danielmaleh/nir-brain-stimulation/README.md

# Transcranial Photobiomodulation (tPBM) — NIR Brain Stimulation Device

An open, low-cost apparatus for delivering **pulsed 850 nm near-infrared light to the scalp** and recording its effect on cortical activity and motor performance. This repository contains everything needed to rebuild the device and run the protocol: Arduino firmware, a browser-based experiment application, an EEG marker bridge, and the calibration and bring-up procedures.

Built at EPFL for a within-subject study in healthy adults comparing **10 Hz NIR**, **40 Hz NIR**, and a **heating-only control**, with continuous EEG, wrist EMG, and an auditory reaction-time task.

---

## What the system is

Three components, each in its own directory, joined over USB serial and a localhost WebSocket:

```
   ┌──────────────────┐   Web Serial    ┌─────────────────┐   D9 ─► NIR LED strip (850 nm)
   │  Browser app     │◄───────────────►│  Arduino Uno    │   D10 ─► heater element
   │  APP/index.html  │   115200 bps    │  firmware/main  │   D2  ◄─ DS18B20 skin temp
   └────────┬─────────┘                 └─────────────────┘
            │ ws://127.0.0.1:3535
            ▼
   ┌──────────────────┐    LSL (~1 ms)   ┌─────────────────┐
   │  lsl_bridge.py   │─────────────────►│  NIC2 / Enobio  │──► EEG + EMG recording
   │ "tPBM-Markers"   │                  │                 │    with markers inside
   └──────────────────┘                  └─────────────────┘
```

- **`firmware/`** — generates the pulse train on a Timer1 compare interrupt (jitter-free 10.00 / 40.00 Hz), runs a feedforward + PI heater controller for the heating control, polls skin temperature every 200 ms, and latches a hard cut-off when the estimated skin-surface temperature reaches 37 °C (raw sensor ≥ 40 °C as backstop).
- **`APP/`** — runs the participant task in Chrome, drives the device over Web Serial, captures keypresses with `performance.now()`, and logs every trial to `localStorage` with CSV export.
- **`lsl_bridge/`** — translates browser events into numeric LSL markers so NIC2 writes them directly into the EEG file on a shared clock.

The device works standalone over USB; no laptop-side runtime is required beyond a browser.

---

## Study design

| | |
|---|---|
| **Participants** | 20 healthy adults, one session each |
| **Design** | Within-subject; the three conditions run in a per-participant randomised order |
| **Conditions** | `Heating Control` · `10 Hz NIR` · `40 Hz NIR` |
| **Per condition** | 13.5 min — a 5-min silent EMG-baseline phase, then a 5-min reaction-time phase, each split at its midpoint by a 1-min cooling break (stimulation off), then the stimulation-off gap (default 1.5 min) that ends every condition and separates it from the next. Stimulation is on for all 10 task minutes. (Changed 2026-10-20 from 10 + 7 min — see `docs/protocol_duration_change.md`.) |
| **Off gap after each block** | Stimulation off for a configurable gap (default 1.5 min, same as the pre gap) — this one window both ends the block and separates it from the next; the last block ends with it too |
| **Total in-protocol time** | ~44 min per participant at the defaults (2.2-min blocked-light calibration, 1.5-min pre gap, three 13.5-min conditions each ending in its 1.5-min off gap), plus EEG capping and setup |
| **Measures** | Continuous EEG (Enobio 32 via NIC2), wrist EMG on EXG channels, auditory reaction time, and a per-block sham-awareness answer (yes / no / don't know, asked by the experimenter when each block's stimulation ends) |
| **Blocked-light calibration** | Before the pre gap, with a card physically covering the light: 30 s each of 10 Hz, 40 Hz, heating and off, as a per-participant noise reference for the drive electronics; then a 10-s window to remove the card |

A **test session** (checkbox in the app's config panel) is identical in timing, structure and markers; it only stamps the CSV `TEST` so a dry run can never pass as participant data, and it is the only kind of session the app allows on a bench firmware build.

### Reaction-time task

A 600 Hz sine tone (10 ms attack, 150 ms decay, generated in the Web Audio API) is presented **5.0 s + a random [0, 2.0] s jitter** after the previous response. The participant presses the spacebar. Each tone opens a **2.0 s response window**; no press is logged as an `OMISSION` and the run continues. A press *before* the tone is a `FALSE_ALARM` and resets the timer. Reaction time is anchored to the *audible* tone onset, not the scheduling call.

---

## Light dose and safety

| Parameter | Value |
|---|---|
| Wavelength | 850 nm |
| Pulse frequencies | 10.00 Hz and 40.00 Hz (Timer1 CTC, prescaler 64) |
| Duty cycle | 50 % |
| Illumination area | ~4 cm² |
| Exposure per condition | 10 min (600 s) light-on, delivered as three blocks (2.5, 5 and 2.5 min) separated by two 1-min cooling breaks — the EMG→RT boundary has no break (pacing keeps skin temperature down) |
| Skin-contact temperature | Hard latching cut-off at an **estimated skin-surface temperature of 37.0 °C** (40 °C limit minus a 3 °C margin covering the estimate's worst-case error), with the raw sensor reading ≥ 40.0 °C as a backstop. The DS18B20 sits behind the contact surface and reads several degrees low and ~90 s late during a ramp, so the firmware estimates the surface from a per-temperature-range gap table plus the reading's slope — see `analysis/thermal/fit_surface_model.py`, which fits the table from a bench run with a reference probe at the contact point and must be re-run whenever the sensor, LED array or heater is remounted. |
| Heating-control set point | Replays, on the device sensor, the device-temperature trajectory recorded during the same session's NIR runs (mean of the preceding NIR runs at the same offset into the run, refreshed every 5 s); falls back to the calibrated profile (baseline + fixed rise) if Heating is the first condition. Tracked by a feedforward + PI controller (`HEATER_PID` telemetry carries the feedforward duty), heater duty capped at 20 % — at that cap the heater's plateau is ~+10 °C on the device sensor, so a residual shortfall against a faster NIR ramp is a power limit, not a control one |

> **Before running participants, measure the delivered irradiance at the scalp with a calibrated power meter** and compute the per-condition fluence as `irradiance × 600 s` (at the nominal ~21 mW/cm² — 84 mW over ~4 cm² — that is ~12.6 J/cm², above the window below, so the measured irradiance decides). Confirm the result against your ethics-approved dose and the published tPBM window (0.3–3 J/cm² useful range, ~5–100 mW/cm² irradiance — see References). Do not infer the dose from the drive current.

Non-negotiable safety properties, all enforced in firmware and verified by `firmware/safety_test/`:

- Skin temperature never exceeds 40 °C — the cut-off acts on the firmware's **estimated skin-surface temperature** (37 °C, i.e. 40 °C minus a 3 °C margin), **latches** and de-energises both channels; it only resets once the sensor reading is back below 40 °C. The raw reading ≥ 40 °C is a second, independent trip.
- A disconnected or faulty DS18B20 (reading −127 °C, or three consecutive 85 °C power-on values) latches a trip rather than failing open.
- The heater target is clamped to stay at least 1 °C below the cut-off, whatever value is commanded.
- Every pulse and temperature reading is timestamped and logged over USB serial.

**Blinding.** NIR at 850 nm is invisible, which is what makes the heating control meaningful. The mode-indicator LEDs are held **off** during active stimulation, and the participant-facing screen is deliberately plain. Do not add visible indicators that activate during a NIR condition.

---

## Repository layout

| Path | Contents |
|---|---|
| `firmware/main/` | Experiment controller — pulse generation, PID heating, safety latch, serial command interface |
| `firmware/io_test/` | Pin-by-pin wiring verification sketch |
| `firmware/safety_test/` | 40 °C cut-off proof — the go/no-go gate before any participant |
| `firmware/onewire_scan/` | DS18B20 bus scanner for diagnosing an undetected sensor |
| `firmware/*/pins.h` | Single source of truth for pin assignments |
| `APP/index.html`, `app.js` | Participant task + researcher dashboard |
| `APP/arduino.html`, `arduino.js` | Hardware dashboard — telemetry, manual control, safety state |
| `APP/io_test.html`, `wiring_check.html` | Bench diagnostics and the interactive wiring checklist |
| `APP/arduino_link.js`, `lsl_markers.js`, `serial_lock.js` | Web Serial link, marker client, cross-tab port arbitration |
| `lsl_bridge/` | WebSocket → LSL marker bridge and its self-test |
| `calibration/` | Thermal calibration script that matches the heating control to NIR warming |
| `hardware/` | Wiring documentation |
| `analysis/` | `trigger_codes.csv` codebook; `behavior/`, `eeg/`, `emg/` for analysis scripts |
| `docs/` | Marker integration guide, methods text, testing and validation procedures |

---

## Reproducing the setup

### 1. Build the hardware

You need an Arduino Uno, an 850 nm SMD2835 LED strip segment, a heater element, a DS18B20 with a 4.7 kΩ pull-up, logic-level MOSFET driver modules, and the supplies for each load.

Work through **`APP/wiring_check.html`** — open it in any browser (no device connection needed) and follow the interactive schematic. It groups the build into three passes: continuity, voltage, then functional. It reflects the current low-side MOSFET topology.

> `hardware/wiring_guide.md` documents an earlier TB6612FNG-based build of the same pin map. The Arduino pin assignments are identical either way; the driver hardware differs. Confirm which one you are building before wiring.

Two things that will bite you: **common ground is mandatory** (the supply negatives, driver grounds, and Arduino GND must all tie together, or the channels never switch), and the **4.7 kΩ pull-up on the 1-Wire data line** is not optional — without it the sensor reads −127 °C and the firmware trips at startup.

### 2. Flash and validate, in order

Install the `OneWire` and `DallasTemperature` libraries, then run the bring-up ladder. Do not skip ahead:

1. **`firmware/io_test/`** — open a serial monitor at 115200 baud (or `APP/io_test.html`). Send `A` and `B` to confirm the NIR and heater channels switch, `T` for a sane temperature, `C` to cycle all four indicator LEDs.
2. **`firmware/safety_test/`** — the safety gate. `H` / `L` toggle the loads, `S` simulates a 41.5 °C spike. **All outputs must cut off and stay off.** `R` must refuse to reset until the real temperature is under 40 °C.
3. **`firmware/main/`** — the full controller. Confirm a steady `PULSE,1` / `PULSE,0` cadence with no `PULSE_DROPPED` lines, and verify 10 Hz and 40 Hz on a scope or photodiode (±0.5 Hz tolerance).

`main` accepts single-letter commands over serial: `M` cycle mode, `G` start, `X` abort, `S` simulate over-temperature, `R` reset the safety latch, `H<temp>` set the heating target (e.g. `H38.25`).

### 3. Install the software

```bash
# LSL marker bridge (needs the native liblsl; bundled on most installs)
pip install -r lsl_bridge/requirements.txt

# Thermal calibration
pip install -r calibration/requirements.txt

# Serve the app — Web Serial requires a real origin, not file://
python -m http.server 8000     # then open http://localhost:8000/APP/
```

Chrome or Edge is required — the app depends on Web Serial and BroadcastChannel, which Firefox and Safari do not implement.

### 4. Calibrate the heating control

The heating control only works as a control if it warms the skin *the same amount* the NIR does. `calibration/calibrate_thermal.py` measures the plateau temperature reached under each condition and writes the matched set point to `thermal_profile.json`:

```bash
python calibration/calibrate_thermal.py --port /dev/cu.usbmodemXXXX
```

This is a **per-device** calibration, not a per-participant one — run it once for a given physical build, and again after any change to the LED segment, heater, or sensor placement. See `calibration/README.md`.

### 5. Run a session

Order matters. The marker outlet must exist before NIC2 starts looking for it:

1. Start the bridge: `python lsl_bridge/lsl_bridge.py` — wait for `LSL Markers outlet 'tPBM-Markers' is live`.
2. In NIC2, enable LSL and point the marker inlet at **`tPBM-Markers`** (case-sensitive, exact match).
3. Start the NIC2 recording.
4. Open `APP/index.html` in Chrome and click **Connect NIR Device** (the task page drives the device itself; do not connect the hardware dashboard during a session). Confirm the console shows `Firmware build: PROTOCOL` — a real session is refused on a BENCH build or without a connected device.
5. **Put the blocking card over the light**, enter the participant ID, and start. The first 2 min are the blocked-light calibration; remove the card when the screen says so (10-s window). The condition order is randomised automatically.
6. When each block's stimulation ends, the sidebar prompts you to ask *"Did you notice the stimulation?"* — click Yes / No / Don't know (the last block's prompt stays open after the session until answered).
7. Stop the NIC2 recording at the end. The app downloads the session CSV, the temperature CSV and a full JSON automatically (Chrome asks once to allow multiple downloads).

Full per-session detail, including Windows-specific pitfalls (COM-port exclusivity, Chrome's Memory Saver discarding the tab mid-session), is in **`SETUP.md`**. Run one full dry run before your first participant and confirm markers land in the recording at sensible times.

**If the device trips mid-session** (estimated skin surface ≥ 37 °C, or raw sensor ≥ 40 °C), the app pauses automatically, emits `SESSION_PAUSE` (code 40), waits until the estimated surface is ≤ 34 °C and the sensor ≤ 37.5 °C, then resumes the *same phase* and emits `SESSION_RESUME` (41). The session is not lost, but the pause is in the marker stream and should be accounted for in analysis.

---

## Data and analysis

Each session produces two aligned artefacts:

- **Behavioural CSV** exported from the app — per-trial reaction times, false alarms, omissions, contact temperature, and condition, all on a `performance.now()` timeline.
- **EEG/EMG recording** from NIC2 (`.easy` + `.info`, or `.edf`) with numeric markers written inline.

Markers are integers because NIC2 does not record string markers. The codebook is `analysis/trigger_codes.csv`, mirrored in `lsl_bridge.py` (`SIMPLE_CODES` / `COND_CODES`):

| Code | Event | Condition | Marker string | Source | Meaning |
|---|---|---|---|---|---|
| `255` | UNKNOWN | — | *(unrecognized)* | bridge | Marker string not in the codebook, or a `cond=` that could not be parsed. Reported on stderr. **Never 0** — the `.easy` trigger column is 0 whenever no marker is present, so a 0 code is indistinguishable from "nothing happened" and vanishes silently from the recording. |
| `1` | TONE | — | `TONE` | task page | Auditory stimulus onset. Reaction time is measured from here |
| `2` | RESPONSE | — | `RESPONSE;rt=312.4` | task page | Spacebar within the 2 s window (the RT value lives in the CSV, not the code) |
| `3` | FALSE_ALARM | — | `FALSE_ALARM` | task page | Spacebar *before* the tone (anticipation); resets the stimulus timer |
| `4` | OMISSION | — | `OMISSION` | task page | No press within the 2 s window (a miss) |
| `10` | SESSION_START | Heating Control | `SESSION_START;cond=Heating` | task page | Session begins, stimulation on |
| `11` | SESSION_START | 10 Hz NIR | `SESSION_START;cond=10Hz` | task page | Session begins |
| `12` | SESSION_START | 40 Hz NIR | `SESSION_START;cond=40Hz` | task page | Session begins |
| `15` | SESSION_END | Heating Control | `SESSION_END;cond=Heating` | task page | Session ends, stimulation off |
| `16` | SESSION_END | 10 Hz NIR | `SESSION_END;cond=10Hz` | task page | Session ends |
| `17` | SESSION_END | 40 Hz NIR | `SESSION_END;cond=40Hz` | task page | Session ends |
| `20` | EMG_START | — | `EMG_START` | task page | 5-min silent EMG-baseline phase begins (2.5 + 1 cool + 2.5; stimulation on, no tones) |
| `21` | EMG_END | — | `EMG_END` | task page | EMG phase ends |
| `22` | RT_START | — | `RT_START` | task page | 5-min reaction-time phase begins (2.5 + 1 cool + 2.5) |
| `23` | RT_END | — | `RT_END` | task page | Reaction-time phase ends |
| `29` | STIM_OFF | — | `STIM_OFF` | device | Stimulation block ended or aborted (NIR and heater off) |
| `31` | NIR_ON | 10 Hz NIR | `NIR_ON;cond=10Hz` | device | NIR light physically ON — 850 nm @ 10 Hz, 50 % duty |
| `32` | NIR_ON | 40 Hz NIR | `NIR_ON;cond=40Hz` | device | NIR light physically ON — 850 nm @ 40 Hz, 50 % duty |
| `34` | HEAT_ON | — | `HEAT_ON` | device | Heater element energised (heating-control condition, PID-regulated) |
| `35` | HEAT_OFF | — | `HEAT_OFF` | device | Heater element off |
| `40` | SESSION_PAUSE | — | `SESSION_PAUSE` | task page | Session frozen by a thermal shutdown (estimated skin surface ≥ 37 °C, or raw ≥ 40 °C); pairs with `99` |
| `41` | SESSION_RESUME | — | `SESSION_RESUME` | task page | Session resumed once the estimated surface was ≤ 34 °C and the sensor ≤ 37.5 °C |
| `42` | COOL_START | — | `COOL_START` | task page | Scheduled mid-phase cooling break begins (stimulation off). Planned pacing — not a safety event |
| `43` | COOL_END | — | `COOL_END` | task page | Scheduled cooling break over; stimulation back on, phase second half resumes |
| `44` | POST_START | — | `POST_START` | task page | Stimulation-off post gap begins — the last step of every condition (after `RT_END`, before `SESSION_END`) |
| `45` | POST_END | — | `POST_END` | task page | Post gap over; `SESSION_END` follows |
| `46` | PRE_START | — | `PRE_START` | task page | Stimulation-off pre gap begins — once, before the first condition's `SESSION_START` |
| `47` | PRE_END | — | `PRE_END` | task page | Pre gap over; the first `SESSION_START` follows |
| `48` | BLOCKED_START | — | `BLOCKED_START` | task page | Blocked-light calibration begins (card on the device) |
| `49` | BLOCKED_END | — | `BLOCKED_END` | task page | Blocked-light calibration over |
| `50` | BLOCKED_SEG | Heating Control | `BLOCKED_SEG;cond=Heating` | task page | 30-s blocked heating segment |
| `51` | BLOCKED_SEG | 10 Hz NIR | `BLOCKED_SEG;cond=10Hz` | task page | 30-s blocked 10 Hz segment (device `NIR_ON` 31 follows) |
| `52` | BLOCKED_SEG | 40 Hz NIR | `BLOCKED_SEG;cond=40Hz` | task page | 30-s blocked 40 Hz segment (device `NIR_ON` 32 follows) |
| `53` | BLOCKED_OFF | — | `BLOCKED_OFF` | task page | 30-s blocked stimulation-off segment |
| `54` | CARD_REMOVE | — | `CARD_REMOVE` | task page | 10-s window to remove the card; `PRE_START` follows |
| `99` | SAFETY_TRIP | — | `SAFETY_TRIP` | device | Thermal cut-off latched (estimated surface ≥ 37 °C, raw ≥ 40 °C, sensor fault, or 1-Wire timeout); all stimulation force-stopped |

Condition-bearing events are encoded as **base code + condition offset** (`Heating` = 0, `10Hz` = 1, `40Hz` = 2), which is why `30` is deliberately unused — the heating control emits `HEAT_ON` (34) instead of a `NIR_ON`. The arithmetic can still *produce* 30 (`NIR_ON` + Heating), which is a contradiction, so the bridge rejects it as invalid rather than writing it. A `cond=` that is missing or misspelt is likewise rejected, never defaulted to offset 0 — silently relabelling a 10 Hz run as the heating arm is unrecoverable after the fact. "Task page" codes originate in the browser app; "device" codes are derived from Arduino serial telemetry, so `11` (the task says stimulation started) and `31` (the device confirms the LED is pulsing) are independent confirmations.

**Keep these codes stable** — analysis scripts key off the exact integers. To epoch: group by the `SESSION_START` codes (10–12), split phases with `EMG_START` / `RT_START` (20 / 22), and confirm the light was physically on using `NIR_ON` (31 / 32) rather than assuming it from the condition label. Load NIC2 files with MNE, or XDF with pyxdf if you recorded via LabRecorder instead.

Expect ~1 ms of LSL synchronisation error plus ~1–3 ms of roughly constant localhost bridge latency — well within what an ERP or tPBM analysis needs. For sub-millisecond auditory ERP latencies you would need a hardware trigger.

---

## Documentation

| Document | Covers |
|---|---|
| [`SETUP.md`](SETUP.md) | Recording-computer install and the per-session startup sequence |
| [`docs/lsl_eeg_marker_integration.md`](docs/lsl_eeg_marker_integration.md) | Why the bridge exists, the full marker vocabulary, NIC2 configuration |
| [`docs/methods_software.md`](docs/methods_software.md) | Manuscript-level description of the control system |
| [`docs/testing_and_validation.md`](docs/testing_and_validation.md) | The bring-up ladder and what each sketch proves |
| [`hardware/wiring_guide.md`](hardware/wiring_guide.md) | Pinout table and per-component wiring |
| [`calibration/README.md`](calibration/README.md) | Thermal matching procedure |
| [`lsl_bridge/README.md`](lsl_bridge/README.md) | Bridge install, run, and self-test |

---

## References

- Vlahinić et al. (2020) — 850 nm, 10 Hz tPBM EEG study in healthy adults
- El Khoury et al. (2019) — 810 nm pulsed tPBM up to 100 mW/cm²
- Salehpour et al. (2018) — LED-based brain PBM review; 10–70 mW/cm² typical, 0.3–3 J/cm² useful fluence window
- [Lab Streaming Layer](https://labstreaminglayer.readthedocs.io/) · [Neuroelectrics LSL/TCP integration](https://www.neuroelectrics.com/lsl-tcp-integration)

---

## Contact

Daniel Elmaleh — EPFL — daniel.elmaleh@epfl.ch

Participant-facing documents and the study protocol are deliberately excluded from this repository.
