danielmaleh/nir-brain-stimulation/docs/lsl_eeg_marker_integration.md

# Tagging the EEG/EMG with Experiment Events — LSL, Enobio & NIC2

A plain-language guide to how we get our experiment's events (tones, key
presses, NIR stimulation on/off) written into the Enobio EEG/EMG recording as
time-stamped **markers**, so the brain/muscle data can be aligned to what
happened in the task.

---

## 1. Why we need this

The Enobio records a continuous stream of EEG (and EMG) samples. On its own,
that stream has no idea *when the participant heard a tone* or *when the 40 Hz
NIR light turned on*. To analyse the data we need to cut the continuous
recording into **epochs** around events — e.g. "the 1 second of EEG after each
tone", or "the EEG during 10 Hz vs 40 Hz stimulation". That requires the
recording to contain **markers**: little labelled flags placed at exact times.

The hard requirement is a **shared clock**: the marker's timestamp and the EEG
samples must be measured on the same timeline, or the epochs land in the wrong
place. Getting that shared clock is the whole job, and it is what Lab Streaming
Layer solves.

---

## 2. The systems and words

| Term | What it is |
|---|---|
| **Enobio (NE)** | The wireless EEG/EMG amplifier (the headset + electrodes). Also does EXG channels for wrist EMG. |
| **NIC2** | *Neuroelectrics Instrument Controller v2* — the PC software that talks to the Enobio, shows signal quality, and **saves the recording** (`.easy` / `.nedf` / `.edf`). |
| **LSL (Lab Streaming Layer)** | A small, free networking system for research. Each data source publishes a **stream**; LSL keeps all streams **synchronized to ~1 ms** on one clock. The standard glue for multimodal experiments. |
| **Outlet** | An LSL "sender". NIC2 publishes EEG as an outlet; our bridge publishes a *Markers* outlet. |
| **Inlet** | An LSL "receiver". NIC2 acts as an inlet for our markers; a recorder acts as an inlet for everything. |
| **Marker / trigger / annotation** | A short event label (a string like `TONE` or a code) placed at a precise time in the recording. Same idea, different names. |

### What NIC2 gives you over LSL
When LSL is enabled in NIC2, it exposes up to four outlets, named after a base
name you choose:

- `NAME-EEG` — the EEG samples
- `NAME-Accelerometer`
- `NAME-Quality` — per-channel signal quality
- `NAME-Markers` — markers

Crucially, **NIC2 can also *receive* markers** from another program (over LSL or
TCP) and **write them straight into the recording file**. That is the path we
use: our experiment produces markers, NIC2 files them next to the EEG. No
separate merge step needed.

---

## 3. Our architecture

Our experiment runs in a **web browser** (`APP/index.html` for the behavioural
task, `APP/arduino.html` for the hardware). Browsers **cannot speak LSL
directly** — LSL is a native (C/UDP) library, and browser JavaScript can't load
it or send the UDP/multicast traffic LSL uses.

So we insert a tiny **local bridge**: a small Python program (using the
`pylsl` library) that:

1. creates an LSL **Markers outlet** (e.g. named `tPBM-Markers`), and
2. listens on a **localhost WebSocket** for events from the browser, pushing
   each one to the outlet the instant it arrives.

```
  index.html   ─┐
                 ├─(localhost WebSocket, ws://127.0.0.1:PORT)─►  Python bridge
  arduino.html ─┘                                                (pylsl outlet
                                                                   "tPBM-Markers")
                                                                        │
                                                                   LSL network
                                                                    (~1 ms sync)
                                                                        │
                                                        NIC2  ──►  writes markers INTO
                                                                   the EEG/EMG recording
```

- The **behavioural app** sends: run/condition start & end, tone onset, key
  press (with reaction time), premature press, and no-response omissions.
- The **hardware dashboard** sends: NIR stimulation start/stop (10 Hz / 40 Hz),
  heating on/off, and safety trips — these mark *when the light was actually on*,
  which for a tPBM study is the most important thing to align the EEG to.

> **Alternative:** instead of NIC2 receiving the markers, you can run the free
> **LabRecorder** tool, which records *every* LSL stream (NIC2's EEG **and** our
> markers) together into one **XDF** file. Both approaches give time-aligned
> data; NIC2-direct keeps everything in NIC2's native file, LabRecorder gives a
> single portable XDF. We default to **NIC2-direct** for simplicity.

---

## 4. The marker vocabulary and numeric codes

> **Important — NIC2 only records NUMERIC markers.** Its docs say plainly *"Do
> not send marker names as objects like 'hand'."* So the browser sends readable
> strings, and **`lsl_bridge.py` translates each into an integer code** before
> pushing to the `tPBM-Markers` LSL outlet (an `int32` Markers stream). NIC2
> stores the integer; you map it back to the event during analysis using the
> table below. (If your NIC2 is configured for "numeric-string" markers rather
> than int32, set `MARKER_FORMAT = "string"` at the top of `lsl_bridge.py`.)

The condition suffix (`Heating`/`10Hz`/`40Hz`) is folded into the code as
an offset, so each condition gets its own number:

Each **session** is one condition, 10 min of task = a 5-min EMG phase then a 5-min
reaction-time phase; each phase is split at its midpoint by a 1-min stimulation-off cooling break, and a 1.5-min stimulation-off post gap ends the condition.

| Marker string (browser → bridge) | Code (bridge → NIC2) | When it fires | Source |
|---|---|---|---|
| `TONE` | `1` | auditory stimulus onset (reaction-time phase) | task page |
| `RESPONSE;rt=312.4` | `2` | space pressed in the window (RT in ms; kept in the CSV, not the code) | task page |
| `FALSE_ALARM` | `3` | space pressed before the tone (anticipation) | task page |
| `OMISSION` | `4` | no press within the 2 s window | task page |
| `SESSION_START;cond=…` | `10`/`11`/`12` | session begins, stimulation on (Heating/10Hz/40Hz) | task page |
| `SESSION_END;cond=…` | `15`/`16`/`17` | session ends, stimulation off (Heating/10Hz/40Hz) | task page |
| `EMG_START` / `EMG_END` | `20` / `21` | 5-min EMG baseline phase start/end (split by a 1-min cooling break) | task page |
| `RT_START` / `RT_END` | `22` / `23` | 5-min reaction-time phase start/end (split by a 1-min cooling break) | task page |
| `SESSION_PAUSE` / `SESSION_RESUME` | `40` / `41` | session frozen by a thermal shutdown (estimated skin surface ≥37 °C, raw ≥40 °C backstop) / resumed once the estimate ≤34 °C and sensor ≤37.5 °C | task page |
| `COOL_START` / `COOL_END` | `42` / `43` | scheduled mid-phase cooling break: stimulation off at each phase midpoint for 1 min / back on for the second half (planned pacing, not a safety event) | task page |
| `POST_START` / `POST_END` | `44` / `45` | stimulation-off post gap ending every condition: 1.5 min after `RT_END`, before `SESSION_END` | task page |
| `PRE_START` / `PRE_END` | `46` / `47` | stimulation-off pre gap, once per participant: 1.5 min before the first `SESSION_START` | task page |
| `BLOCKED_START` / `BLOCKED_END` | `48` / `49` | blocked-light calibration (card covering the light), once per participant, before the pre gap | task page |
| `BLOCKED_SEG;cond=…` / `BLOCKED_OFF` | `50`/`51`/`52` / `53` | its 30-s segments: Heating / 10 Hz / 40 Hz, then off | task page |
| `CARD_REMOVE` | `54` | 10-s window to remove the card | task page |
| `NIR_ON;cond=…` | `31`/`32` | NIR light physically ON (10Hz/40Hz) | device telemetry |
| `STIM_OFF` | `29` | device stimulation block ends/aborts | device telemetry |
| `HEAT_ON` / `HEAT_OFF` | `34` / `35` | heater element switches (heating condition) | device telemetry |
| `SAFETY_TRIP` | `99` | thermal cutoff latched (estimated surface ≥37 °C, raw ≥40 °C, sensor fault) | device telemetry |
| *(anything unrecognized, or a `cond=` that cannot be parsed)* | `255` | written into the recording so the problem is visible; never 0 (0 = no marker in the `.easy` file) | bridge |

The codebook lives in `lsl_bridge.py` (`SIMPLE_CODES` / `COND_CODES`). Keep the
codes **stable** — your analysis scripts key off these exact integers. The
bridge prints the whole codebook at startup and logs each `event -> code` as it
fires, so you can watch the mapping live.

---

## 5. Setup checklist (once per session)

1. **Install the bridge dependencies** (one time): `pip install pylsl websockets`.
   `pylsl` needs the native `liblsl` library present (bundled on most installs;
   otherwise install `liblsl`).
2. **Start the bridge** program *before* NIC2's recording. It prints something
   like `LSL Markers outlet 'tPBM-Markers' is live`.
3. **Configure NIC2**: enable LSL, and in NIC2's marker/LSL settings point it at
   the outlet name **`tPBM-Markers`**.
   - ⚠️ The name is **case-sensitive** and must match *exactly*.
   - ⚠️ The marker outlet **must already exist** (bridge running) *before* you
     start the NIC2 protocol/recording, or NIC2 won't find it.
4. **Start the NIC2 recording.**
5. **Open the experiment** in Chrome; it connects to the bridge automatically.
   Run the session as normal.
6. **Stop the NIC2 recording** at the end. The markers are now inside the file.

**Sanity check before real participants:** run one short test session and
confirm the markers appear in the NIC2 recording at sensible times (e.g. a `TONE` roughly every ~5–7 s during the RT phase, each followed by a `RESPONSE` or `OMISSION`).

---

## 6. Timing accuracy — what to expect

- LSL synchronizes streams to about **1 ms**, which is well within what an ERP
  or tPBM analysis needs.
- Our localhost bridge adds a small, roughly constant **~1–3 ms** delay between
  the browser event and the LSL push. That is fine for this study.
- The behavioural app already captures the *true* event time with
  `performance.now()` (microsecond resolution) and anchors the tone marker to
  the **audible onset** (including audio output latency). If you ever need
  sub-millisecond precision (e.g. exact auditory ERP latencies), the bridge can
  forward that original timestamp so LSL stamps the marker at the true event
  time rather than at receipt — or you move to a **hardware trigger**, which is
  the gold standard but needs extra electronics.

---

## 7. Analysis (later)

- **NIC2 native file** (`.easy` + `.info`, or `.edf`): markers appear as an
  events column / annotations. In Python, load with **MNE** and read the events
  into annotations; epoch around each marker string.
- **XDF file** (if you used LabRecorder): load with **pyxdf**, then hand the EEG
  stream + marker stream to MNE. The two share LSL timestamps, so alignment is
  automatic.
- Group epochs by condition using the `SESSION_START` codes (10/11/12), split the
  EMG vs reaction-time phases with `EMG_START`/`RT_START` (20/22), and confirm the
  light was physically on with the `NIR_ON` codes (31/32) — to compare 10 Hz vs
  40 Hz vs heating.

---

## 8. References

- Neuroelectrics — [LSL & TCP Integration](https://www.neuroelectrics.com/lsl-tcp-integration)
- Neuroelectrics Support — [Set Up LSL](https://supportne.freshdesk.com/support/solutions/articles/35000292694-set-up-lsl)
- Neuroelectrics Wiki — [Interacting with NIC](https://ne-wiki.netlify.app/index.php/interacting_with_nic)
- Lab Streaming Layer — [official docs & LabRecorder](https://labstreaminglayer.readthedocs.io/)
- `pylsl` (Python bindings) — [pypi.org/project/pylsl](https://pypi.org/project/pylsl/)

---

*Implementation: `lsl_bridge/lsl_bridge.py` (bridge), `APP/lsl_markers.js`
(browser client), `analysis/trigger_codes.csv` (codebook).*
