danielmaleh/nir-brain-stimulation/docs/figures/session_timeline.png

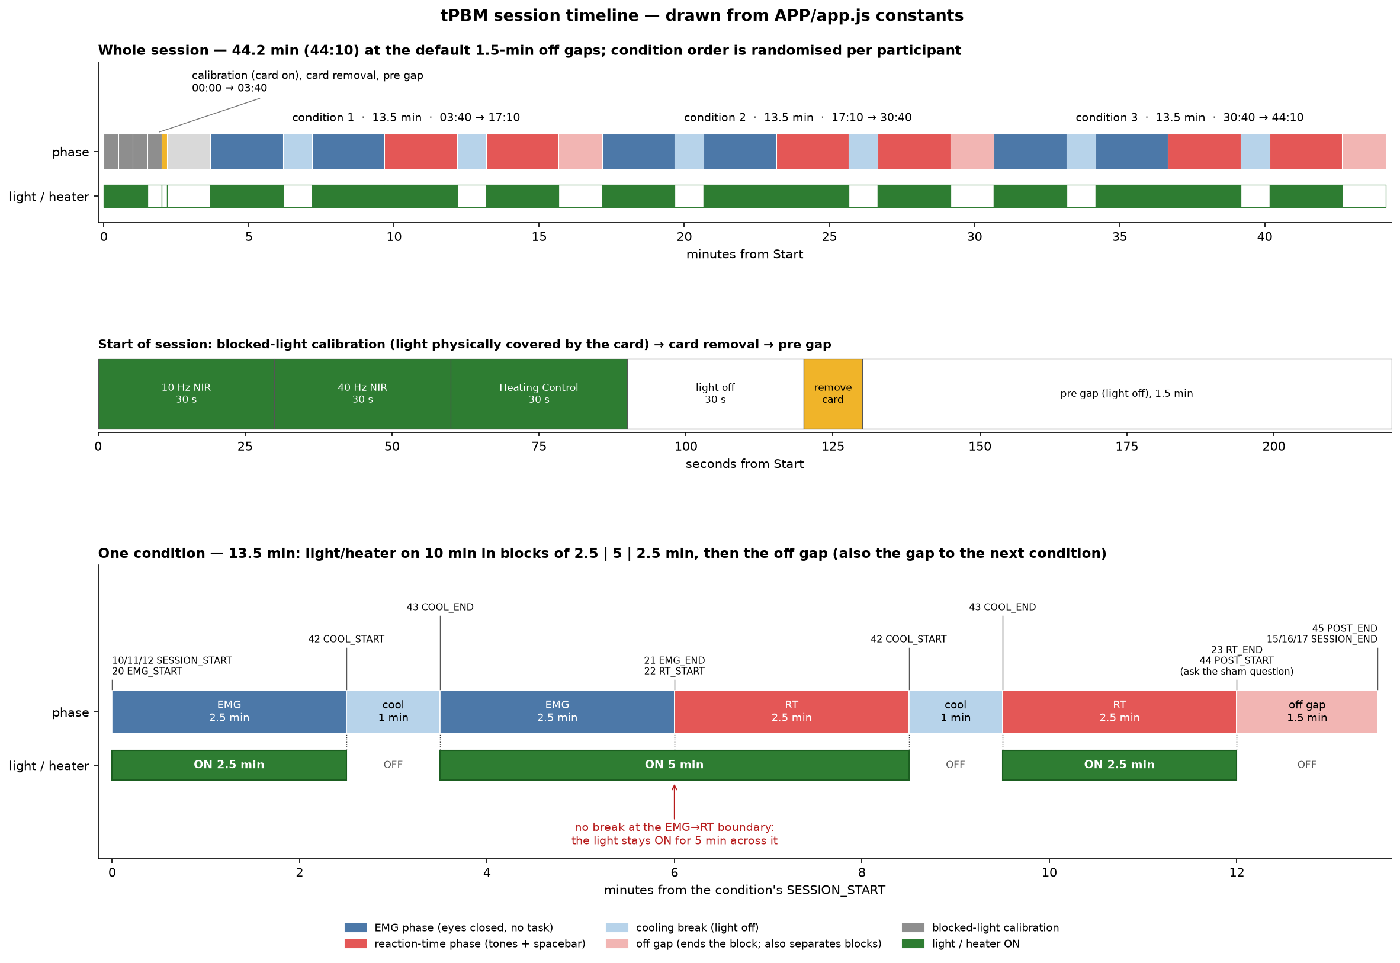
docs/figures/session_timeline.png
