danielmaleh/nir-brain-stimulation/analysis/trigger_codes.csv

code | event | condition | source | description
255 | UNKNOWN |  | bridge | Unrecognized marker string, or a cond= that could not be parsed (see the bridge stderr; add it to the codebook in lsl_bridge.py). Never 0: the .easy trigger column is 0 when no marker is present, so a 0 code would be indistinguishable from 'nothing happened'.
1 | TONE |  | task | Auditory stimulus onset during the reaction-time phase. Reaction time is measured from here.
2 | RESPONSE |  | task | Spacebar pressed within the 2 s response window. The RT in ms is in the behavioural CSV, not the code.
3 | FALSE_ALARM |  | task | Spacebar pressed before the tone (anticipation). Resets the stimulus timer.
4 | OMISSION |  | task | No press within the 2 s response window (a miss).
10 | SESSION_START | Heating Control | task | Session begins (stimulation starts) — heating control condition.
11 | SESSION_START | 10 Hz NIR | task | Session begins — 850 nm NIR pulsed at 10 Hz.
12 | SESSION_START | 40 Hz NIR | task | Session begins — 850 nm NIR pulsed at 40 Hz.
15 | SESSION_END | Heating Control | task | Session ends (stimulation stops) — heating control condition.
16 | SESSION_END | 10 Hz NIR | task | Session ends — 10 Hz NIR.
17 | SESSION_END | 40 Hz NIR | task | Session ends — 40 Hz NIR.
20 | EMG_START |  | task | 5-min silent EMG-baseline phase begins (2.5 min + 1-min cooling break + 2.5 min; no tones/clicks; stimulation is on outside the break).
21 | EMG_END |  | task | EMG phase ends.
22 | RT_START |  | task | 5-min reaction-time phase begins (2.5 min + 1-min cooling break + 2.5 min; tones + responses).
23 | RT_END |  | task | Reaction-time phase ends.
40 | SESSION_PAUSE |  | task | Session frozen by a thermal shutdown (skin temp exceeded 40 C); paired with SAFETY_TRIP.
41 | SESSION_RESUME |  | task | Session resumed after the temperature recovered to <=37.5 C (stimulation restarted).
42 | COOL_START |  | task | Scheduled mid-phase cooling break begins (stimulation off). Planned pacing, NOT a safety event — each phase is split at its midpoint by a 1-min break.
43 | COOL_END |  | task | Scheduled cooling break over; stimulation back on and the phase second half resumes.
44 | POST_START |  | task | Stimulation-off post gap begins — the last step of every condition (RT_END precedes it, SESSION_END follows). 1.5 min.
45 | POST_END |  | task | Post gap over; SESSION_END follows.
46 | PRE_START |  | task | Stimulation-off pre gap begins — once per participant, before the first condition's SESSION_START. 1.5 min.
47 | PRE_END |  | task | Pre gap over; the first SESSION_START follows.
48 | BLOCKED_START |  | task | Blocked-light calibration begins — card physically covering the light; per-participant noise reference of the drive electronics.
49 | BLOCKED_END |  | task | Blocked-light calibration over.
50 | BLOCKED_SEG | Heating Control | task | Blocked-light calibration: 30-s heating segment (card on).
51 | BLOCKED_SEG | 10 Hz NIR | task | Blocked-light calibration: 30-s 10 Hz NIR segment (card on; device NIR_ON 31 follows).
52 | BLOCKED_SEG | 40 Hz NIR | task | Blocked-light calibration: 30-s 40 Hz NIR segment (card on; device NIR_ON 32 follows).
53 | BLOCKED_OFF |  | task | Blocked-light calibration: 30-s stimulation-off segment.
54 | CARD_REMOVE |  | task | 10-s window to remove the blocking card; PRE_START follows.
29 | STIM_OFF |  | hardware | Device stimulation block ended or aborted (NIR/heater off).
31 | NIR_ON | 10 Hz NIR | hardware | NIR light physically ON — 850 nm pulsed at 10 Hz, 50% duty.
32 | NIR_ON | 40 Hz NIR | hardware | NIR light physically ON — 850 nm pulsed at 40 Hz, 50% duty.
34 | HEAT_ON |  | hardware | Heater element energised (heating-control condition; PID-regulated).
35 | HEAT_OFF |  | hardware | Heater element off.
99 | SAFETY_TRIP |  | hardware | 40 C skin-temperature safety cutoff latched — all stimulation force-stopped.
