danielmaleh/nir-brain-stimulation/(commit log)

2026-06-23 Initial project scaffold for NIR tPBM brain stimulation study
    Sets up folder structure, CLAUDE.md with full project context (device specs,
    safety requirements, light dose parameters, software architecture), and
    copies study documents into docs/. Arduino firmware and Python analysis
    code to be built incrementally.
2026-07-02 Add design spec for interactive wiring verification schematic
2026-07-02 Fix pins.h include so sketches actually compile in Arduino builds
    Arduino copies the sketch to a temp build folder, so the relative
    include ../main/pins.h could never resolve. Symlink pins.h into each
    sketch folder instead, keeping firmware/main/pins.h the single source
    of truth.
    [io_test.ino, main.ino, pins.h, safety_test.ino]
2026-07-02 Add interactive wiring verification schematic (APP/wiring_check.html)
    Clickable SVG schematic of every connection (Arduino, TB6612, DS18B20,
    NIR strip, heater, PSU, indicator LEDs) with per-wire test instructions
    in bring-up order and confirmation state persisted in localStorage.
2026-07-02 Clarify STBY on io_test page: tied to 5V by default, driver always enabled
    When the firmware reports TB6612_STBY,NA the indicator now shows
    enabled and the Y toggle disables itself instead of implying the
    driver must be switched on manually.
2026-07-03 Auto-reconnect dashboards after tab discard/reload
    Chrome Memory Saver discards inactive tabs; the reloaded page lost its
    Web Serial connection. On load, reuse the already-granted port
    (preferring USB vendor 0x2341 = Arduino) and reconnect without a picker.
2026-07-03 Draw TB6612FNG as the real breakout module in the wiring schematic
    Red PCB with the actual pad layout (pins 1-8: VM VCC GND A01 A02 B01
    B02 GND; pins 16-9: PWMA AIN2 AIN1 STBY BIN1 BIN2 PWMB GND), pin
    numbers as printed on the board, and the page re-routed to match:
    loads and 12V on the output side, Arduino facing the control side.
2026-07-10 Rework wiring schematic for MOSFET + 24V topology
    The LED strip is a 24V part (6 LEDs per resistor group), which the
    TB6612 cannot drive (VM max ~15V). Redraw the schematic as two
    logic-level N-channel MOSFET low-side switches: load+ to supply+,
    load- to MOSFET drain, source to a common ground bus, Arduino D9/D10
    to the gates. NIR on 24V; heater on its own rail pending a rated-
    voltage check. Firmware/pin map unchanged (still PWM-gates D9/D10).
    Checklist rewritten to 26 items in bring-up order; net IDs re-verified
    against the SVG.
2026-07-10 Reaction-time task: don't stall on a missed keypress
    Previously the next tone was only scheduled from handleKeyPress, so if
    the participant never pressed space the run went silent until it timed
    out. Add a 2s response window after each tone: no press logs a
    NO_RESPONSE omission, increments missedCount, and schedules the next
    stimulus so the run continues. A press within the window cancels the
    pending miss. Misses are persisted per-run and shown in the summary.
    Verified end-to-end over CDP: tone -> NO_RESPONSE -> next tone (run
    continues), and a press within the window logs a response with no
    spurious miss.
2026-07-13 Add LSL marker bridge and wire experiment events to it
    New lsl_bridge/ (Python): publishes an LSL 'tPBM-Markers' outlet and
    relays browser events to it over a localhost WebSocket, so NIC2 (or
    LabRecorder) time-stamps them into the Enobio EEG/EMG recording.
    APP/lsl_markers.js: best-effort browser sender (auto-reconnect, drops
    rather than buffers when offline so timing stays correct).
    Wired markers:
    - app.js: RUN_START;cond, STIM (at audible onset), RESPONSE;rt,
    PREMATURE, NO_RESPONSE, RUN_END;cond
    - arduino.js: STIM_ON;cond, STIM_OFF, HEATER_ON/OFF, SAFETY_TRIP
    - index.html/arduino.html include lsl_markers.js
    Verified end-to-end: bridge self-test (WS->LSL PASS); driving index.html
    headle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
2026-07-14 Fix hardware dashboard showing UNKNOWN state/mode at idle
    Two display bugs made the dashboard look dead even though the board
    responds: (1) main never announces IDLE at boot, so state stayed
    UNKNOWN — on connect the Uno resets into IDLE+Heating, so show that
    immediately; (2) TEMP_LOG carries condition -1 while idle, which the
    mode display wrote every second, clobbering the selected mode back to
    UNKNOWN even after Cycle Mode — only update the mode display during
    stimulation (condIdx >= 0).
2026-07-15 Fix hardware-dashboard safety bugs, add live condition switch and cross-tab serial lock
    Firmware (firmware/main/main.ino):
    - Reject the DS18B20 +85 C power-on artifact (gate reads on isConversionComplete,
    SENSOR_SUSPECT after repeats) so it no longer falsely trips the 40 C cutoff
    - Emit explicit PULSE,0/HEATER,0 on abort/trip; keep polling temp during a trip;
    emit STATE_CHANGE on reset so the dashboard clears
    - Allow live condition switching (M) during stimulation via COND_SWITCH
    Dashboard (APP/): handle COND_SWITCH + SENSOR_SUSPECT, auto-scaling temp
    sparkline, clear stale actuator/safety UI. New serial_lock.js coordinates the
    hardware and I/O-diagnostics tabs so they stop stealing the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
    [main.ino]
2026-07-16 Bridge: translate string markers to integer codes for NIC2
    NIC2 only records numeric markers, so string markers (STIM_ON;cond=40Hz)
    were silently dropped and never reached the EDF. The bridge now maps each
    event to a stable integer code via a documented codebook and pushes an int32
    Markers stream (MARKER_FORMAT switch for numeric-string NIC2 setups).
2026-07-16 Task page drives Arduino NIR stimulation per run
    The experiment task page (index.html) now owns the serial port and drives the
    Arduino: at each run it selects the matching condition and starts stimulation,
    stopping it at run end/abort so the NIR follows the task's 40s/20s clock (not
    the firmware's 60s timer). Wrist EMG keeps the board OFF. New arduino_link.js
    reuses serial_lock.js (dashboard yields the port) and re-emits the hardware LSL
    markers (STIM_ON/OFF, HEATER, SAFETY_TRIP) since the dashboard is disconnected
    during a session. Uses the existing firmware command set (no reflash).
2026-07-17 Add trigger-code lookup table for analysis
    analysis/trigger_codes.csv maps every integer marker code NIC2 records back to
    its event, condition, source, and meaning. Verified against lsl_bridge.py so the
    table and the bridge codebook cannot drift.
    [trigger_codes.csv]
2026-07-18 Add NIR-matched heating-control thermal calibration
    Heating control now reproduces the temperature the NIR stimulation reaches,
    matching the warmth confound instead of a fixed 37.5 C set point.
    - firmware: mutable heater set point + 'H<temp>' serial command (clamped below
    the 40 C cutoff) so the host can set the matched target at run time.
    - calibration/calibrate_thermal.py: runs 10/40 Hz for the run duration, records
    DS18B20 temperature, computes the plateau, and stores thermal_profile.json
    (canonical in calibration/, browser copy in APP/). Persistent, calibrate once.
    - APP/arduino_link.js: loads the profile and sends the matched target before the
    heating-control run; falls back to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
    [calibrate_thermal.py, main.ino]
2026-07-20 Add PID closed-loop control for the heating condition
    Replaces the on-off hysteresis thermostat with a PID controller that holds the
    (NIR-matched) heating-control target tightly. Output is applied as a
    time-proportioned slow-PWM duty over a 1 s window, so it needs no PWM pin and
    cannot collide with the Timer1 NIR pulse generator (which never runs in the
    heating condition). Recomputed at 5 Hz; integral anti-windup and an EMA-smoothed
    derivative (Kd defaults to 0 given the 10-bit sensor). Streams HEATER_PID
    diagnostics (duty/temp/target) at 1 Hz for tuning. Gains are starting values and
    must be tuned on hardware; the 40 C latching cutoff still overrides everything.
    HEATER_USE_PID=0 reverts to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
    [main.ino]
2026-07-22 Heater safety: 50% duty cap + rate-of-rise trip
    After a 24V heater thermal-runaway (ran to 100 C; the firmware 40 C cutoff could
    not stop it because the MOSFET stayed conducting), add two software mitigations:
    HEATER_MAX_DUTY caps heater power at 50%, and a rate-of-rise cutoff trips if temp
    climbs >5 C/s (catches a runaway ~1 s sooner). Neither protects against a shorted
    MOSFET -- an independent in-line thermal fuse is still required. Compile-only;
    not yet hardware-tested.
    [main.ino]
2026-07-23 Delta-based heating match + cleaner thermal calibration
    Match the NIR's temperature RISE, not an absolute temperature: bench ambient
    (~room temp) is far below skin (~32-34C), so an absolute target is meaningless.
    - calibrate_thermal.py: store heating_rise_c (plateau minus baseline, averaged
    over 10/40Hz); cool_until_stable() waits for thermal equilibrium between
    conditions (robust vs chasing a fixed ambient). Schema bumped to v2.
    - arduino_link.js: track live TEMP_LOG; at a heating run read the baseline skin
    temp and target baseline + rise via H<setpoint>. Falls back to firmware default.
    - firmware: HEATER_MAX_DUTY 0.20 (the NIR job is a gentle ~0.75C rise; 20% is
    ample, higher woul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
    [calibrate_thermal.py, main.ino]
2026-07-27 Lower heater target floor to 20C; add 1-Wire scanner sketch
    - firmware: HEATER_TARGET_MIN 25->20 C so delta-matched targets (baseline + ~0.74C
    rise) aren't clamped on a cool bench / cool room. The 39C ceiling (safety clamp)
    is unchanged.
    - firmware/onewire_scan: throwaway DS18B20 bus diagnostic (presence pulse + ROM
    enumeration) that pinpointed the loose sensor wire; kept as a reusable tool.
    [main.ino, onewire_scan.ino]
2026-07-27 Robust experiment-page serial connection + temp monitor + stop-reason
    Fixes the experiment page (index.html) dropping offline right after connecting
    and never driving the device (worked on the dashboard, not the real page):
    - arduino_link.js: no double-open (connect() no-ops if already connected;
    openPort closes stale handles); removed the cross-tab takeover RACE (connect
    opens directly; a busy port gives a clear "disconnect the dashboard" message);
    the experiment page now HOLDS the port firmly and never yields; detects
    unexpected drops (readLoop exit) and reports OFFLINE with a reason; watchdog
    distinguishes CONNECTED-but-silent from RECEIVING.
    - Live contact-temperature monitor o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
2026-07-28 17-min EMG+RT sessions, stim throughout, redesigned NIC2 markers, temp in CSV
    Session restructure (app.js/index.html): 3 conditions (Heating/10Hz/40Hz), Wrist
    EMG dropped as a condition. Each session is 17 min = 10-min silent EMG-baseline
    phase (no tones/clicks) + 7-min reaction-time phase; NIR/heating runs the whole
    time. Two-phase run lifecycle, M:SS phase countdowns, participant rest screen
    during EMG.
    Firmware: STIMULATION_DURATION_MS raised 60s -> 18 min safety ceiling (the host
    ends runs; this only fires if the host never does) — fixes the pilot LED dropout.
    Markers redesigned for meaning: SESSION_START/END, EMG_START/END, RT_START/END,
    TONE, RESPONSE, FALSE_ALARM, OMISSION, NIR_ON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
    [trigger_codes.csv]
2026-07-28 Thermal shutdown -> auto-pause, wait for cool-down, resume same phase
    If a safety cutoff (>40 C) fires mid-session, the experiment now freezes instead
    of running on with no stimulation:
    - Pause: stop the phase countdown + tones, remember the phase and time left, show
    a "Paused - cooling down" screen, and mark SESSION_PAUSE (SAFETY_TRIP already
    sent by the device layer). Keypresses/tones are suppressed while paused.
    - Resume: watch the temperature; once it recovers to <=37.5 C, clear the device
    trip ('R'), restart the condition's stimulation, show a "Good temperature -
    resuming" message, mark SESSION_RESUME, and continue the SAME phase with the
    exact time that was left.
    arduino_lin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
    [trigger_codes.csv]
2026-08-06 Clear stale Timer1 OCF1A flag before arming the NIR pulse ISR
    Every NIR run began with a degenerate PULSE,1/PULSE,0 pair ~12 us apart
    at STIM_START, before the real train. It was a real (optically
    negligible) 12 us LED assertion, not a logging artifact.
    The Arduino core's init() leaves Timer1 free-running with OCR1A = 0, so
    TCNT1 hits the compare value constantly and OCF1A stays latched in TIFR1
    with nothing to clear it. startNirPulse() enabled OCIE1A with that flag
    pending, so the ISR fired on the very next instruction and toggled the
    just-raised NIR pin back LOW.
    Clear OCF1A (write-1-to-clear) before enabling the interrupt. This makes
    arming idempotent regardless of prior Timer1 state, a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
2026-08-06 Retune heater PID from measured step response; fix anti-windup clamp
    The heating control has to reproduce the NIR's calibrated +0.74 C rise
    (calibration/thermal_profile.json), but a bench step test overshot a
    2.5 C set point by 2.75 C -- roughly 4x the entire effect it exists to
    imitate.
    Characterised the thermal process from that step response (22.0 -> 24.0 C
    at 20% duty): initial rise 0.0403 C/s, Newton cooling gives tau ~= 253 s,
    process gain K ~= 51 C per unit duty, sensor/transport lag theta ~= 40 s.
    Holding +0.74 C needs only ~1.45% duty, but Kp = 0.60 commanded a capped
    20% on that error -- ~14x the steady-state requirement -- so the output
    stayed saturated straight through the set p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
    [main.ino]
2026-08-06 Report Web Serial failures the operator can act on
    The dashboard reported every connection failure as the same generic
    "Connection failed: <message>", and Chrome's own text is actively
    misleading: requestPort() says "No port selected by the user" both when
    the chooser was dismissed AND when no chooser was ever presented. The
    second case happens in embedded browser panes that do not implement the
    Web Serial picker, and it reads as though the operator cancelled.
    That cost real bench time today -- repeated failed connects while lsof
    showed nothing holding the port, because the picker was never rendered.
    describeSerialError() now distinguishes the cases, telling the two
    NotFoundError variants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
2026-08-06 Add project README with the LSL/EEG marker codebook
    Documents the system end to end: what the three components are and how
    they connect, the study design, the light dose and safety properties,
    the repository layout, and the reproduction path from wiring through the
    firmware bring-up ladder to running a session.
    Includes the full trigger codebook -- code, event, condition, marker
    string, source and meaning for all 24 markers -- mirroring
    analysis/trigger_codes.csv and the SIMPLE_CODES / COND_CODES tables in
    lsl_bridge.py. Also documents the base-code-plus-condition-offset scheme
    (Heating 0, 10Hz 1, 40Hz 2) and why code 30 is deliberately unused: the
    heating control emits HEAT_ON (34) rather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
2026-08-06 Make unencodable markers loud instead of silently wrong
    Three ways a marker could be lost or mislabelled in the recording, all
    silent, all only discoverable after a participant had been run.
    UNKNOWN_CODE 0 -> 255. The trigger column of a Neuroelectrics .easy file
    is 0 whenever no marker is present, so encoding an unrecognised marker
    as 0 made it indistinguishable from "nothing happened" -- it vanished.
    255 is outside the codebook and shows up in any downstream check.
    Alias HEATER_ON/HEATER_OFF -> HEAT_ON/HEAT_OFF. The dashboard emits the
    first spelling, the codebook defines the second, so heater events were
    encoded as unknown -- which, with the old UNKNOWN_CODE of 0, meant they
    disappeared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
    [trigger_codes.csv]
2026-08-06 Announce the active thermal cutoff on every boot
    The board carries no record of which firmware it holds. After a bench
    session that raised MAX_SAFE_TEMP, the only trace was a comment in a
    branch you might not be on -- so a serial log gave no way to tell
    afterwards whether a run had thermal protection.
    setup() now prints a machine-greppable BUILD line every boot:
    BUILD,PROTOCOL,cutoff=40.0
    BUILD,BENCH,cutoff=150.0
    and, when the cutoff differs from the protocol's 40 C, a loud human
    banner as well -- including a specific warning when the cutoff is above
    the DS18B20's 125 C range, where the check is unreachable rather than
    merely higher.
    Derived from MAX_SAFE_TEMP by comparing it against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
2026-08-28 Add a test-session toggle: 5-min conditions + firmware build gate
    A "Test session" checkbox in the config panel runs a shortened bench
    dry-run: 2.5 min EMG + 2.5 min RT per condition instead of 10 + 7.
    Markers, randomisation, rest pauses and stimulation control are
    unchanged -- only the two phase durations switch -- and the run is
    stamped TEST in the session log, the calibration card, and a loud
    banner line in the exported CSV, so a dry-run can never pass as
    participant data. The toggle locks while a session is active and
    unlocks on reset.
    The toggle deliberately does NOT touch the thermal cutoff. MAX_SAFE_TEMP
    is compiled into the firmware; no page control can change it, and wiring
    the saf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
2026-09-14 Split each real-session phase with a 1.5-min mid-phase cooling break
    Bench measurements (2026-08) showed the rig climbing ~1.5-2.5 C/min at
    protocol duty with no plateau, so an unbroken 10-min EMG or 7-min RT
    phase walks the skin temperature into the 40 C cutoff mid-session. Real
    sessions now split each phase at its midpoint and switch stimulation
    OFF for a fixed 1.5-min cool-down, then resume the second half:
    EMG 5:00 | cool 1:30 | EMG 5:00 | RT 3:30 | cool 1:30 | RT 3:30
    Per-condition time goes 17 -> 20 min (~57 -> ~66 min in-protocol); the
    delivered light energy is unchanged - the same 17 minutes of on-time,
    paced. Test sessions still run their phases unbroken.
    The breaks are marked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
    [trigger_codes.csv]
2026-09-17 Keep task events out of cooling breaks; one tone chain after the break
    A spacebar press during an RT cooling break fell through handleKeyPress
    (runPhase stays 'RT' during the break), logged FALSE_ALARM and started a
    self-sustaining TONE/OMISSION loop with stimulation OFF, because none of
    the task paths checked inCoolingBreak. resumeRtSecondHalf then scheduled
    a fresh chain without clearing the old timers, so two tone chains raced
    through the second half (extra tones; RTs could be measured against the
    wrong tone). Analysis treats COOL_START..COOL_END (42/43) as task-free,
    stimulation-off windows, so this inflated false-alarm and omission counts
    and could corrupt second-half RTs.
    Reproduced o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
2026-09-17 Draw false alarms on the chart again; fix stale comments and timer reset
    - plotDataPoints still filtered for PREMATURE_PRESS, the event name
    before c4b5c0e, so false alarms were never drawn. They are logged as
    FALSE_ALARM and now appear again as the small baseline dots on the
    live chart, redrawn on the next valid response as before.
    - resetControlInterface set the time-left readout to '40.0s', left over
    from the old 40-second runs; it now shows '--:--', the page's initial
    value.
    - Comments said a miss is logged as NO_RESPONSE; the event and marker
    are OMISSION (code 4).
    - The scheduleNextStimulus doc said [0, 1s] jitter; JITTER_MAX_MS is 2 s.
    Verified on the real page: a false a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
2026-09-22 Add thermistor-vs-device temperature alignment tool
    Joins an external thermistor log with the app's temperature CSV on shared
    wall-clock time, interpolates the thermistor at each device reading, and
    emits aligned/per-phase CSVs plus an HTML plot. This is the tool behind
    the 2026-09-11 bench finding that the device DS18B20 under-reads by up
    to ~9.5 C and lags ~57 s during ramps — the numbers driving the sensor
    placement/cutoff review before participants.
2026-09-23 Trip the safety cutoff on an estimated skin-surface temperature
    The DS18B20 sits behind the contact surface. Against a reference probe
    at the skin-contact point it read several degrees LOW and ~90-100 s LATE
    during a warming ramp: on 2026-09-11 the surface reached 42.5 C while
    the device read 34.0 and the 40 C cutoff never fired. The final device
    carries no surface probe, so the firmware now estimates the surface
    from the device reading alone and trips on the estimate.
    Model (fitted, not hand-tuned):
    surface = device + gap[device] + rate * (device - device_40s_ago) / 40
    gap[] is a per-temperature-range table (nodes every 2 C, linear between)
    and `rate` carries the lag. A table WITHOUT t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
2026-09-23 Heating replays the session's NIR device-temperature trajectory; add post gap
    HEATING CONTROL. The control condition must reproduce, on the device
    sensor, what that sensor recorded during the same participant's NIR
    runs -- not a fixed rise calibrated on another day with another build
    (the July +0.74 C target was being hit exactly while the LEDs now warm
    the bench surface by +13-15 C). At heating-run start the page builds
    the device-temperature trajectory of every NIR run already completed
    in this session from the temperature log, and every 5 s sends the mean
    of those runs at the same offset into the run as an H command. The
    provider is armed before runCondition() so its initial H already
    car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
    [trigger_codes.csv]
2026-10-04 Add a stimulation-off pre gap before the first condition
    Conditions 2 and 3 are preceded by an off period (the previous
    condition's post gap plus the rest), and every condition ends with the
    post gap, but the first condition started stimulating the moment the
    session began. A 1.5-min stimulation-off pre gap now runs once, before
    the first SESSION_START, so every condition has an off window on both
    sides. It applies to test sessions too.
    Marked PRE_START/PRE_END (46/47), added to the bridge, the trigger
    codebook, README and the marker guide. No run is open yet during the
    gap, so it is recorded in the session data (preGapMs), the temperature
    log (phase PRE) and the marker stream rather than i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
    [trigger_codes.csv]
2026-10-07 Give test sessions the same cooling-break structure as real ones
    Test sessions already had the pre gap and the post gap, but ran their
    5-min phases unbroken. They now split each phase at the midpoint with a
    1-min stimulation-off cooling break (TEST_COOLING_BREAK_MS; real
    sessions keep 1.5 min), so a dry run exercises exactly the structure,
    timers and markers a participant session does:
    PRE_START/END, SESSION_START, EMG_START, COOL_START/END, EMG_END,
    RT_START, COOL_START/END, RT_END, POST_START/END, SESSION_END
    phaseSplit() is now true for both kinds; coolingBreakMs() picks the
    duration. The config-panel description and the calibration card show
    the test-session shape. CSV stays stampe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
2026-10-07 Add static figure renderer for aligned thermistor/device tables
    Produces the PNG/PDF/SVG version of an align_thermistor.py table for
    slides and papers (the HTML it writes is for on-screen reading). This
    is the script behind the 2026-09-17 device-vs-probe figure that drove
    the surface-estimate cutoff.
2026-10-20 Promote the 5+5-min timing to the protocol; blocked-light calibration; sham question; auto-export; heater trajectory tracking
    PROTOCOL TIMING. The former test-session timing is now the protocol:
    EMG 2.5 | cool 1 | EMG 2.5 | RT 2.5 | cool 1 | RT 2.5 | post gap 1.5
    = 13.5 min per condition, 600 s light-on (was 10 + 7 min, 1020 s, with
    1.5-min breaks). Test sessions keep identical timing and differ only in
    the TEST stamp and bench-build gating. README, CLAUDE.md, the marker
    guide, the bridge comments and trigger_codes.csv are updated, and
    docs/protocol_duration_change.md tabulates original / interim / current
    timing, whole-session time (57 -> 72 -> ~50 min), fluence formulas and
    nominal numbers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
2026-10-26 Readiness audit fixes: real-session gate, block-3 sham answer, abort races, firmware fail-safes, docs
    Outcome of a read-only audit of firmware, app, codebook, docs and a fresh
    clone before the first participant. Verified in-browser with shortened
    durations and on the attached board.
    APP (session logic):
    - A REAL session now refuses to start unless the device is connected and
    has reported a PROTOCOL build; previously an unknown build (not yet
    connected, pressed Start before the boot banner, no device at all)
    passed the gate silently and the session ran all three conditions
    with no stimulation. Test sessions may still run without a device.
    - Block 3's sham-awareness answer could only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
2026-10-26 Add session-timeline figure generated from the app constants
    docs/figures/session_timeline.py reads the phase/gap durations and the
    blocked-light segments from APP/app.js and renders the whole session, the
    calibration start and one condition with the light/heater ON track and
    marker codes (uv run docs/figures/session_timeline.py). Regenerate it
    whenever the timing constants change; the PNG/SVG are for the paper.
